Yonig79/ThermoMed/Hardware/PCB_Layout/PCB 2D_2.png

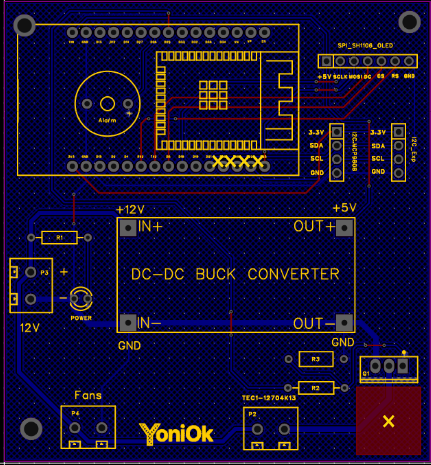
Hardware/PCB_Layout/PCB 2D_2.png
