Yonig79/ThermoMed/Doc/Pictures/Protoboard_ESP32.jpg

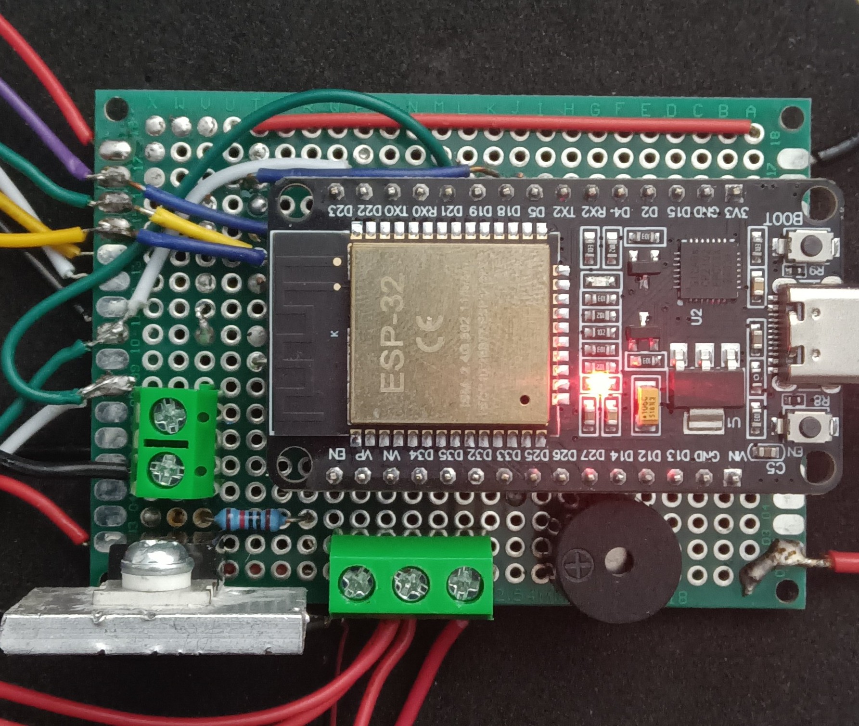
Doc/Pictures/Protoboard_ESP32.jpg
