Yonig79/ThermoMed/Doc/Pictures/Front view_1.jpg

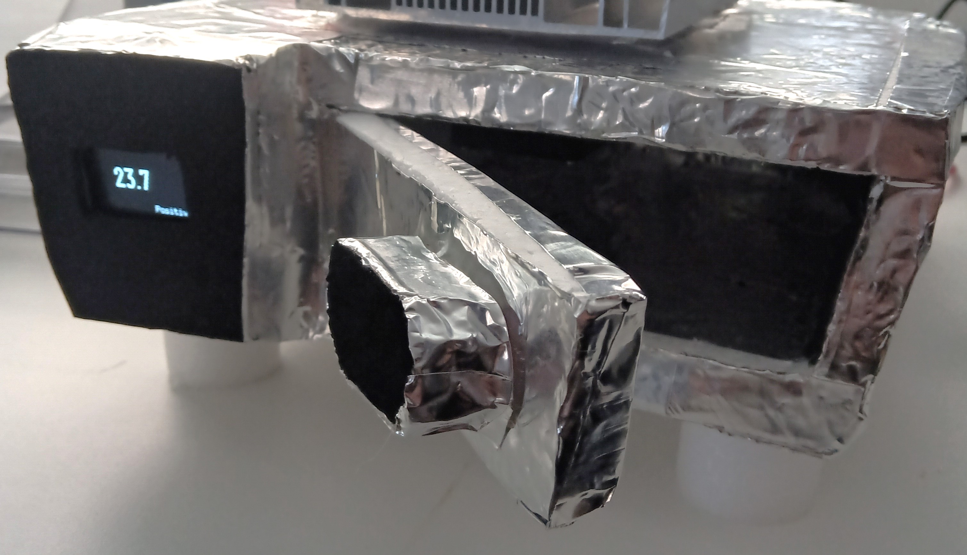
Doc/Pictures/Front view_1.jpg
