Yonig79/ThermoMed/Doc/Pictures/Front view_2.jpg

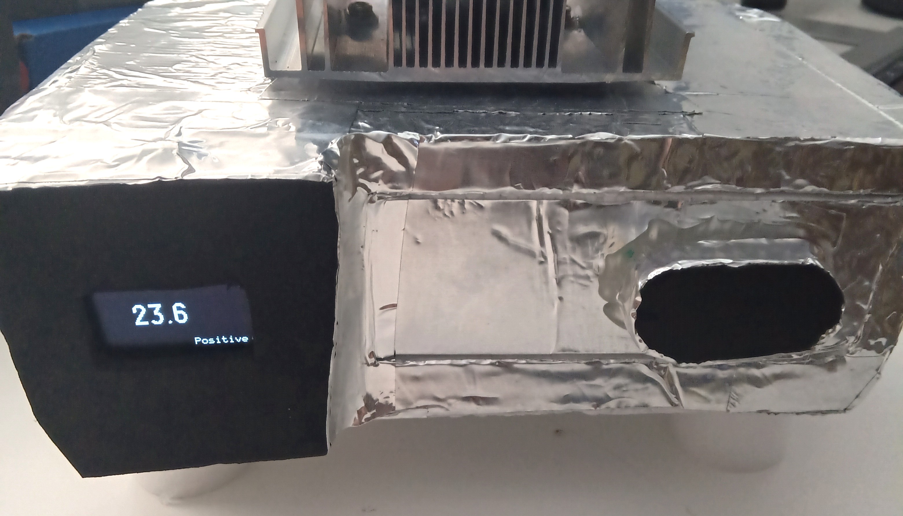
Doc/Pictures/Front view_2.jpg
