Yonig79/ThermoMed/Doc/Pictures/Peltier_Cell.jpg

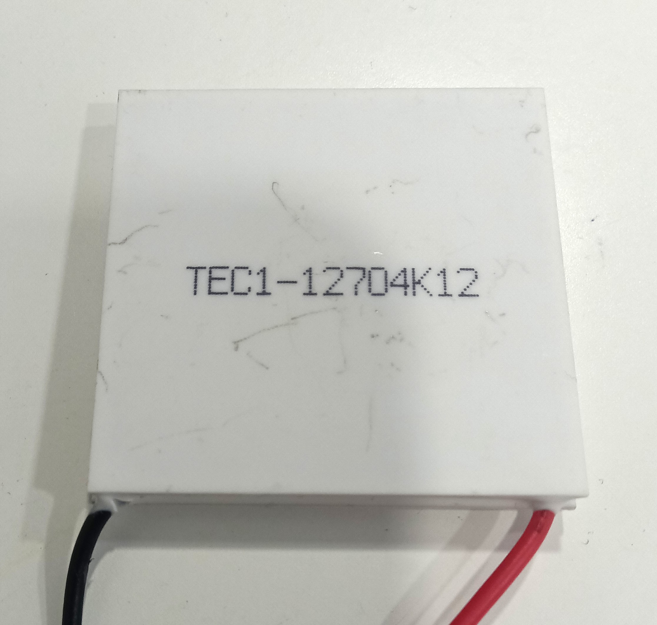
Doc/Pictures/Peltier_Cell.jpg
