Yonig79/ThermoMed/Doc/Pictures/Sensor_ESP32.jpg

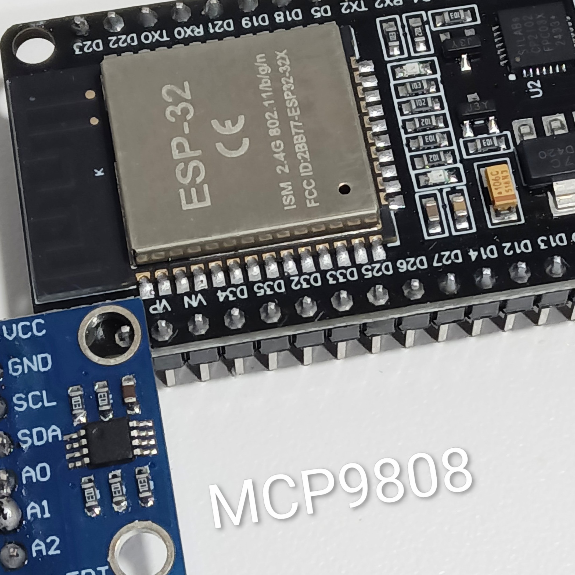
Doc/Pictures/Sensor_ESP32.jpg
