Yonig79/ThermoMed/Doc/Pictures/SH1106(SPI).jpg

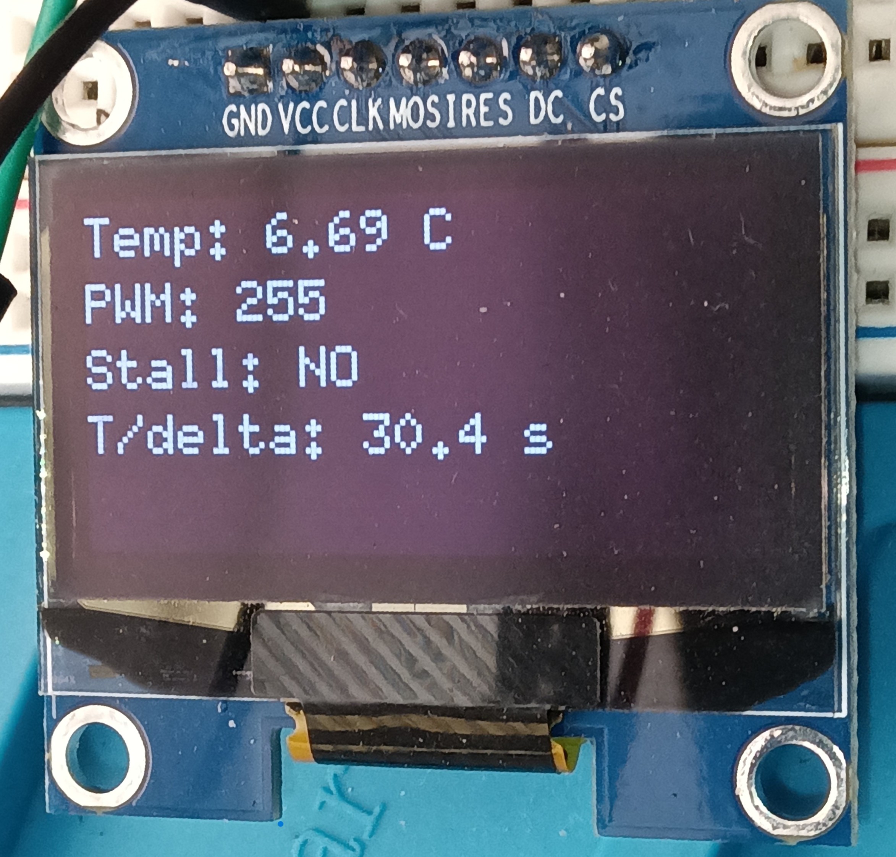
Doc/Pictures/SH1106(SPI).jpg
