Yonig79/ThermoMed/Doc/Pictures/Top view_2.jpg

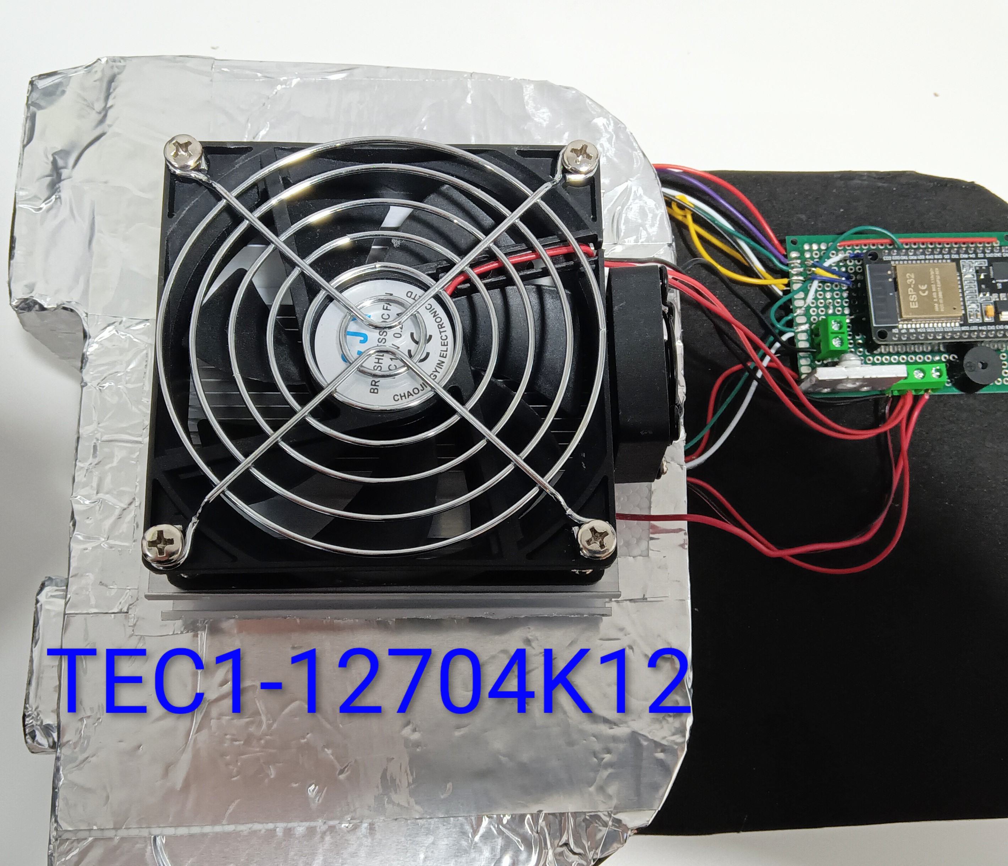
Doc/Pictures/Top view_2.jpg
