Yonig79/ThermoMed/Hardware/PCB_Layout/PCB 2D.png

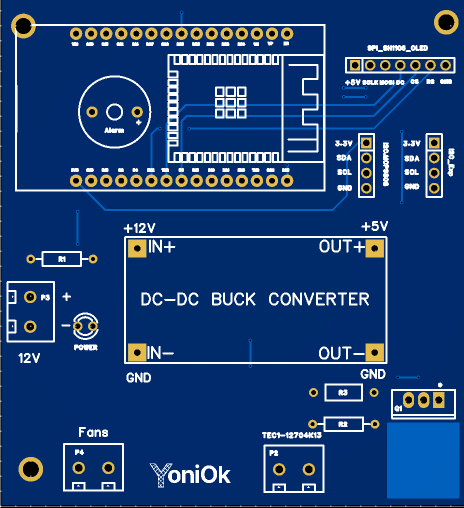
Hardware/PCB_Layout/PCB 2D.png
