Yonig79/ThermoMed/Hardware/PCB_Layout/PCB 3D_1.png

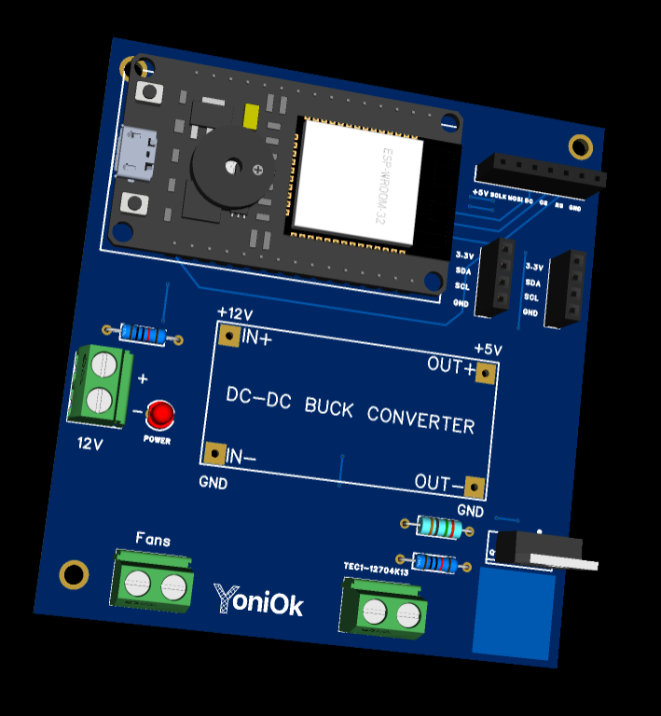
Hardware/PCB_Layout/PCB 3D_1.png
