Yonig79/ThermoMed/Hardware/BOM/BOM_Board1_PCB1_2025-11-03.xlsx

No. | Quantity | Comment | Designator | Footprint | Value | Manufacturer Part | Manufacturer | Supplier Part | Supplier
1 | 1 | 2.4kHz | Alarm | BUZ-TH_BD12.0-P7.60-D0.6-FD | 2.4kHz | TMB12A05 | 华能 | C96093 | LCSC
2 | 1 | ModuloEsp32 | ESP1 | ModuloESP32
3 | 2 | 2.54-1*4P母 | I2C,MCP9808,I2C_Exp | HDR-TH_4P-P2.54-V-F |  | 2.54-1*4P母 | BOOMELE(博穆精密) | C2718488 | LCSC
4 | 1 | Celda de Peltier | P2 | CONN-TH_WJ126V-5.0-2P |  | Celda de Peltier | KANGNEX(康奈克斯电气) | C8404 | LCSC
5 | 1 | Fans | P3 | CONN-TH_WJ126V-5.0-2P |  | Fans | KANGNEX(康奈克斯电气) | C8404 | LCSC
6 | 1 | Source_+12V | P4 | CONN-TH_WJ126V-5.0-2P |  | Source_+12V | KANGNEX(康奈克斯电气) | C8404 | LCSC
7 | 1 | LED_TH-R_3mm | POWER | LED-TH_BD3.0-P2.54-FD
8 | 1 | IRLB8721PBF | Q1 | TO-220-3_L10.0-W4.5-P2.54-L |  | IRLB8721PBF | Infineon(英飞凌) | C153222 | LCSC
9 | 1 | 4.7kΩ | R1 | RES-TH_BD2.3-L6.5-P10.50-D0.5 | 4.7kΩ | MF1/4W-4.7KΩ±1% T | CCO(千志电子) | C119339 | LCSC
10 | 1 | 220Ω | R2 | RES-TH_BD2.3-L6.5-P10.50-D0.5 | 220Ω | CF1/4W-220Ω±5% T | CCO(千志电子) | C120039 | LCSC
11 | 1 | 10kΩ | R3 | RES-TH_BD2.7-L6.2-P10.20-D0.4 | 10kΩ | MF1/4W-10K±1%-ST52 | VO(翔胜) | C2903232 | LCSC
12 | 1 | HDR-F_2.54_1x7P | SPI_SH1106_OLED | HDR-TH_7P-P2.54-V-F
13 | 1 | LM2596-STEPDOWN-MODULE-R | U3 | LM2596
