Yonig79/ThermoMed/Hardware/Schematic/SCH_Schematic1_2025-11-03.pdf

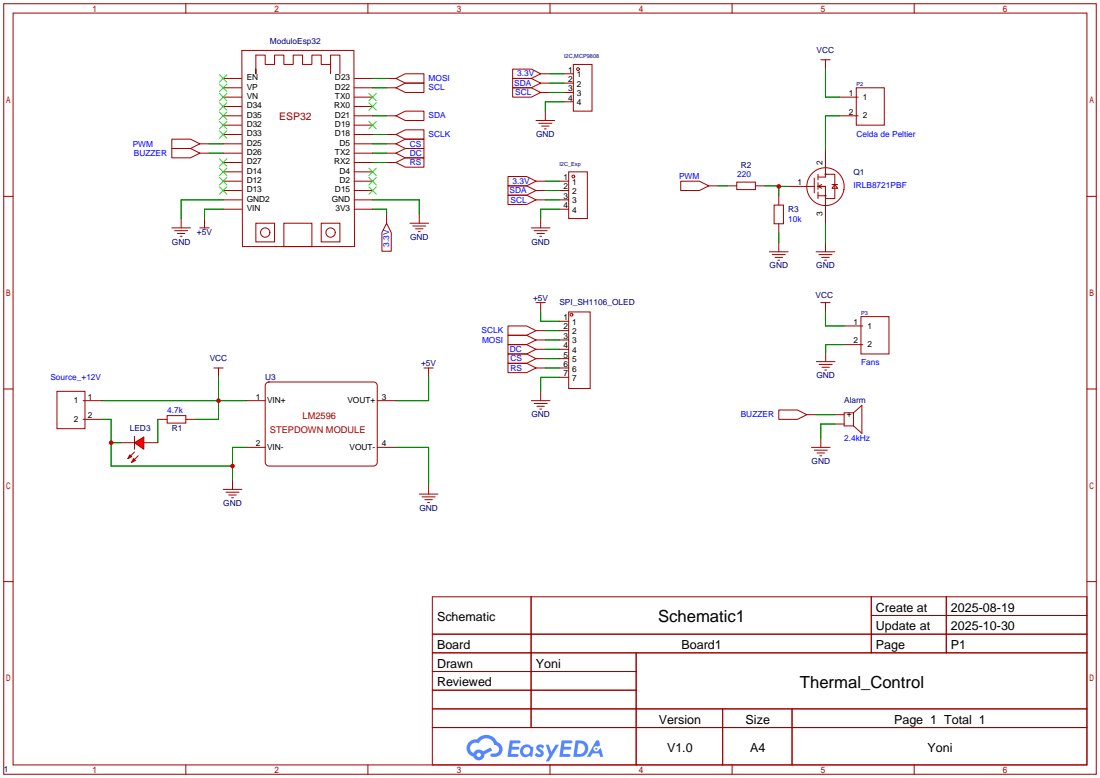
[picture p13: page 1]

Schematic | Schematic1 | Create at | 2025-08-19

Update at | 2025-10-30

Board | Board1 | Page | P1
Drawn | Yoni | Thermal_Control
Reviewed

Version | Size | Page 1 Total 1
V1.0 | A4 | Yoni
