Yonig79/ThermoMed/(commit log)

2025-10-29 Initial upload of firmware source code for temperature control system
2025-10-29 Add prototype photos in Doc/pintures folder
2025-11-03 Add Gerber, Bom, layout, and shematic files
    [BOM_Board1_PCB1_2025-11-03.xlsx]
2025-11-03 Add evaluation data CSV file
    [Evaluation_Decision_Avg_Deviation.csv]
